nva1773/MMC2190-Auto-On-Off/Firmware/Config.jpg

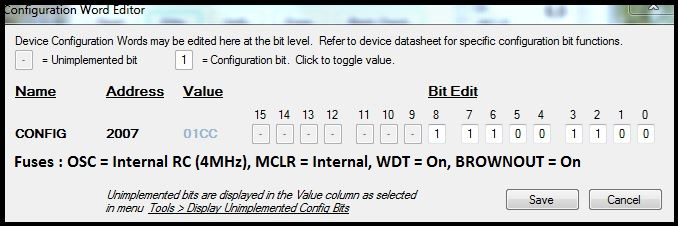
Firmware/Config.jpg
