nva1773/MMC2190-Auto-On-Off/Hard/Connect AECD.JPG

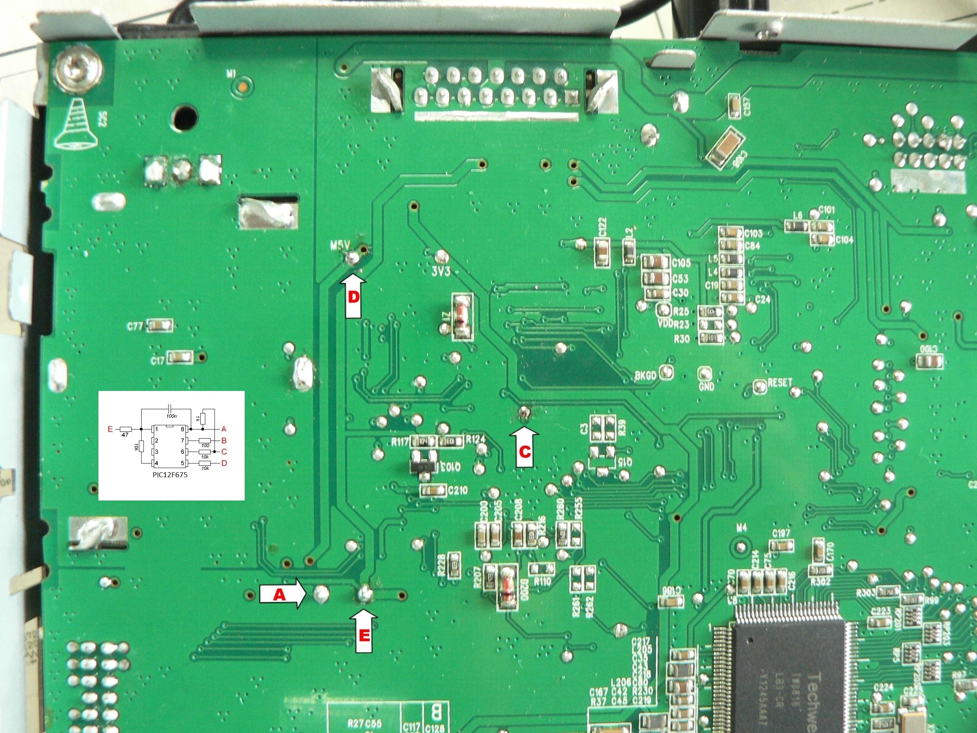
Hard/Connect AECD.JPG
