nva1773/MMC2190-Auto-On-Off/Hard/Connect B.JPG

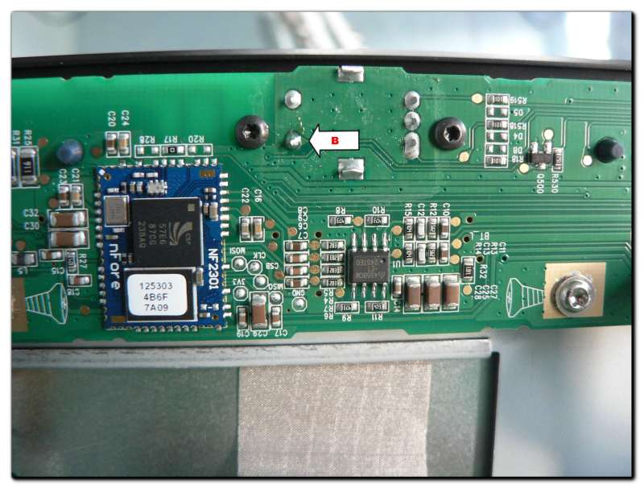
Hard/Connect B.JPG
