nva1773/MMC2190-Auto-On-Off/Hard/Разъем MMC 2190.jpg

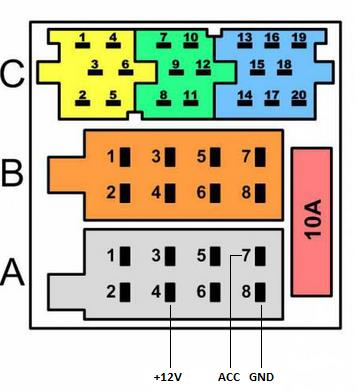
Hard/Разъем MMC 2190.jpg
