nva1773/MMC2190-Auto-On-Off/(list of files, drawings)

Other design files:
Proteus/mmc_on_off.DSN
